yutish3/High-speed-LFR/README.md

# LFR - 2026
STM32 line follower robot on a custom 2-layer PCB. Black Pill (STM32F411) as a brain, TB6612FNG motor driver, 16-channel ARC16 line sensor, MPU6050 , and 3S LiPo through a 5V buck converter.



## VISION
I wanted to make a LFR that will be really good for competitions and i didt wanted it to fail mid run or during travel so i decided to make a pcb for it



Main goals:
- everything on a single PCB: power, motor driver, sensor connector, IMU
- run straight from a 3S LiPo with a power switch
- battery voltage monitoring so the robot knows when the pack is getting low (used 2 resistors for it connected to blackpill)
- status LEDs, a RESET button and a SAVE button for calibration
- test points for power pins

## what makes it special (main components)

&#9679; STM32F411CEU6 (Black Pill) :- main microcontroller, 100 MHz Cortex-M4 with hardware FPU

&#9679; TB6612FNG :- dual H-bridge motor driver for two N20 gear motors

&#9679; ARC16 :- 16-channel IR line sensor array on a single 8-pin header

&#9679; MPU6050 :- 6-axis IMU for gyro-assisted turning and stabilisation

&#9679; 3S LiPo + buck converter :- 11.1V battery, with the 5V rail for the sensor and the MCU

&#9679; N20 600 RPM motors :- small, light and fast for the size

## Images











## Bill of Materials

| Component | Purpose | Qty | Cost (INR) | Distributor |
| --- | --- | --- | --- | --- |
| N20 12V 600 RPM motor | main motor | 4 | ₹916 | Online |
| 11.1V 850mAh 30C 3S LiPo Battery Pack | Main power | 1 | ₹1,159 | Online |
| ARC16 Line Sensor | 16-channel IR line sensor array | 1 | ₹1,499 | Online |
| N20 Wheels | wheels | 1 | ₹349 | Online |
| N20 Caster Ball Wheel | Third support point | 1 | ₹39 | Online |
| Push Button 6x6x5 (pack of 10) | RESET and SAVE buttons | 1 | ₹19 | Online |
| 100 uF 35V cap | VSW bulk decoupling | 2 | ₹24 | Online |
| 220 uF 25V cap | +5V bulk decoupling | 4 | ₹28 | Online |
| XT60 Female to Nylon T-Connector | Battery plug adapter | 1 | ₹131 | Online |
| XT60PW Male Connector | Battery connector | 1 | ₹70 | Online |
| Rocker Switch | Main power switch | 1 | ₹12 | Online |
| Black Pill (STM32F411CEU6) | Main microcontroller | 1 | - | Bought offline |
| TB6612FNG Motor Driver | Dual motor driver | 1 | - | Bought offline |
| MPU6050 Module | 6-axis IMU | 1 | - | Bought offline |
| 5V Buck Converter Module | Battery to 5V (BUCK1) | 1 | - | Bought offline |
| Custom PCB | PCB | 1 | 1500 | whypcb |
