yutish3/High-speed-LFR/production/LFR_pcb_bom.csv

Designator | Footprint | Quantity | Value | LCSC Part #
+3V3 | TestPoint_THTPad_D2.0mm_Drill1.0mm | 1 | +3V3
+5V | TestPoint_THTPad_D2.0mm_Drill1.0mm | 1 | +5V
BLACK-PILL1 | BLACK PILL | 1 | ~
BUCK1 | Untitled_1 | 1 | ~
C1, C3 | CP_Radial_D6.3mm_P2.50mm | 2 | 100µF
C2, C4 | CP_Radial_D8.0mm_P3.50mm | 2 | 220µF
D1 | LED_D3.0mm | 1 | GREEN
D2 | LED_D3.0mm | 1 | RED
GND | TestPoint_THTPad_D2.0mm_Drill1.0mm | 1 | GND
J1 | AMASS_XT60PW-M_1x02_P7.20mm_Horizontal | 1 | Battery connector
J4 | SolderWire-0.25sqmm_1x02_P4.2mm_D0.65mm_OD1.7mm | 1 | LEFT MOTOR
J5 | SolderWire-0.25sqmm_1x02_P4.2mm_D0.65mm_OD1.7mm | 1 | RIGHT MOTOR
J7 | PinHeader_1x08_P2.54mm_Vertical | 1 | LFS-16A sensor
J9 | PinSocket_1x08_P2.54mm_Vertical | 1 | MPU6050
JW2 | SolderWire-0.5sqmm_1x02_P4.6mm_D0.9mm_OD2.1mm | 1 | SWITCH
R1, R2 | R_Axial_DIN0207_L6.3mm_D2.5mm_P10.16mm_Horizontal | 2 | 330Ω
R3, R6 | R_Axial_DIN0207_L6.3mm_D2.5mm_P10.16mm_Horizontal | 2 | 10k
R4 | R_Axial_DIN0207_L6.3mm_D2.5mm_P10.16mm_Horizontal | 1 | 15k
R5 | R_Axial_DIN0207_L6.3mm_D2.5mm_P10.16mm_Horizontal | 1 | 33k
RESET | SW_PUSH_6mm | 1 | RESET
SAVE | SW_PUSH_6mm | 1 | SAVE
U2 | TB6612FNG_Breakout_2x07_P2.54mm | 1 | TB6612FNG_Module
VSW | TestPoint_THTPad_D2.0mm_Drill1.0mm | 1 | VSW
