yutish3/High-speed-LFR/CAD file/3d print file.step

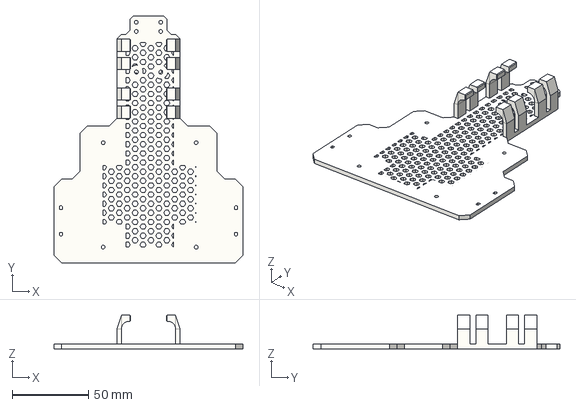
[picture p1: CAD file, 2026-11-07]
CAD file/3d print file.step
124.0 x 161.8 x 22.0 mm
