yutish3/High-speed-LFR/(list of files, cad)

Other CAD files:
CAD file/new LFR chassis.f3z
