yutish3/High-speed-LFR/lfr-main files/lfr.kicad_pcb

## KiCad design lfr-main files/lfr.kicad_pcb (2026-10-20)

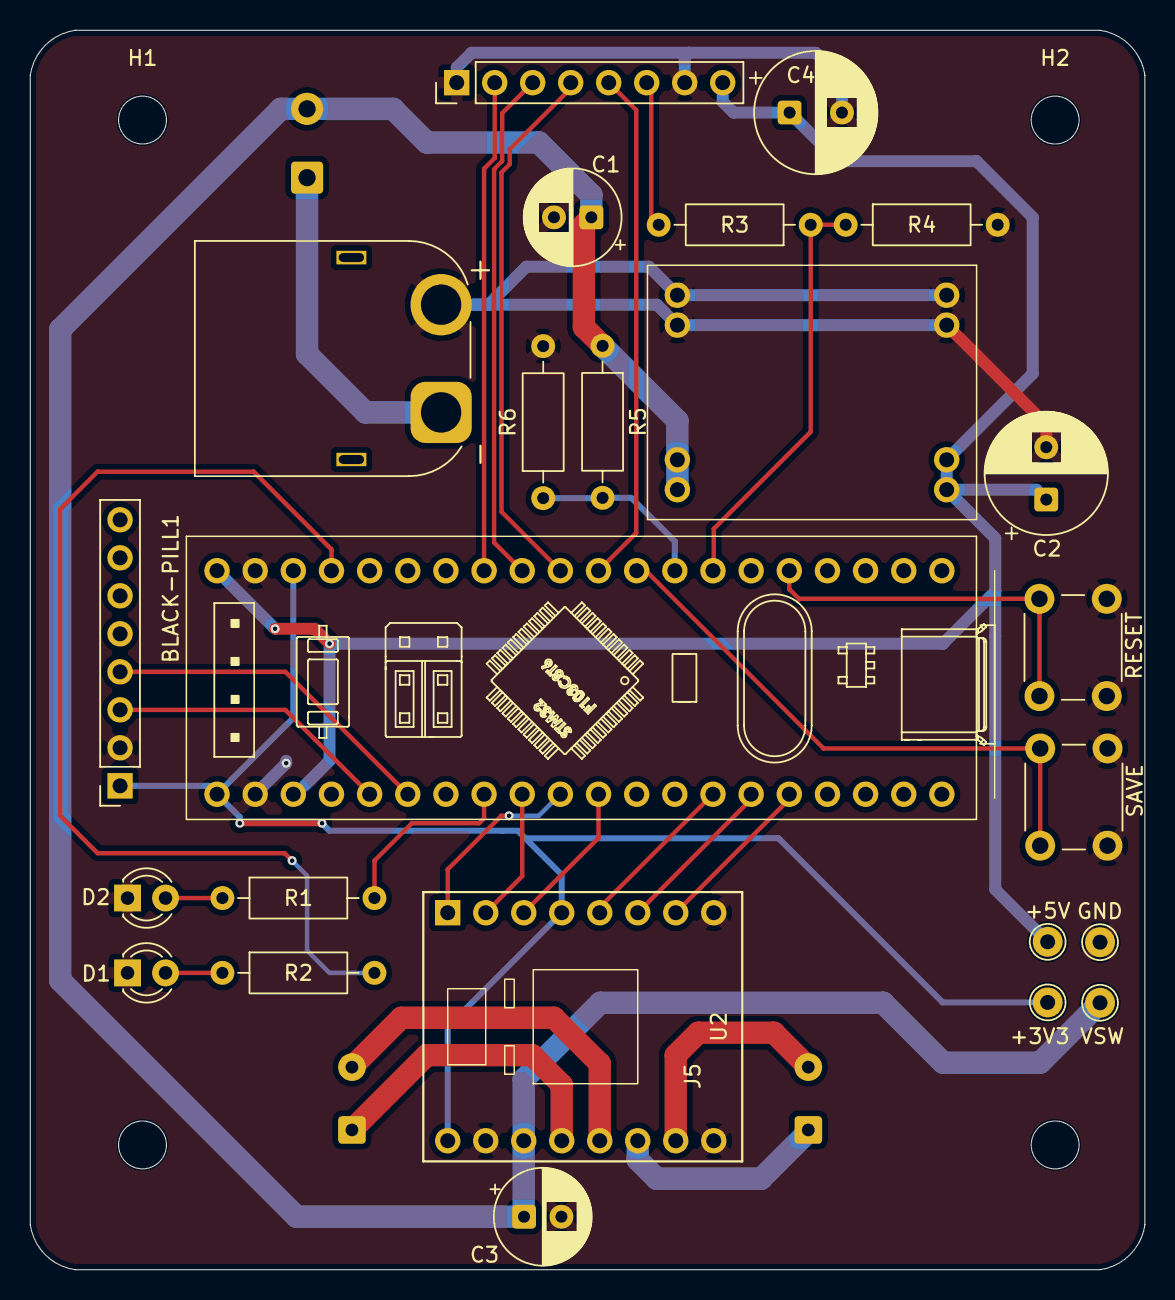
[picture p2: board lfr.kicad_pcb from above]

Board: 2 copper layers, 74.5 x 82.8 mm, 31 parts (0 on the bottom side), 30 nets.

Parts:
+3V3: +3V3; TestPoint_THTPad_D2.0mm_Drill1.0mm
+5V: +5V; TestPoint_THTPad_D2.0mm_Drill1.0mm
BLACK-PILL1: BLACK PILL
BUCK1: Untitled_1
C1, C3: 100µF; CP_Radial_D6.3mm_P2.50mm
C2, C4: 220µF; CP_Radial_D8.0mm_P3.50mm
D1: GREEN; LED_D3.0mm
D2: RED; LED_D3.0mm
GND: GND; TestPoint_THTPad_D2.0mm_Drill1.0mm
H1, H2, H3, H4: MountingHole; MountingHole_3.2mm_M3
J1: Battery connector; AMASS_XT60PW-M_1x02_P7.20mm_Horizontal
J4: LEFT MOTOR; SolderWire-0.25sqmm_1x02_P4.2mm_D0.65mm_OD1.7mm
J5: RIGHT MOTOR; SolderWire-0.25sqmm_1x02_P4.2mm_D0.65mm_OD1.7mm
J7: LFS-16A sensor; PinHeader_1x08_P2.54mm_Vertical
J9: MPU6050; PinSocket_1x08_P2.54mm_Vertical
Jw2: SWITCH; SolderWire-0.5sqmm_1x02_P4.6mm_D0.9mm_OD2.1mm
R1, R2: 330Ω; R_Axial_DIN0207_L6.3mm_D2.5mm_P10.16mm_Horizontal
R3: 10k; R_Axial_DIN0207_L6.3mm_D2.5mm_P10.16mm_Horizontal
R4: 15k; R_Axial_DIN0207_L6.3mm_D2.5mm_P10.16mm_Horizontal
R5: 33k; R_Axial_DIN0207_L6.3mm_D2.5mm_P10.16mm_Horizontal
R6: 10K; R_Axial_DIN0207_L6.3mm_D2.5mm_P10.16mm_Horizontal
RESET: RESET; SW_PUSH_6mm
SAVE: SAVE; SW_PUSH_6mm
U2: TB6612FNG_Module; TB6612FNG_Breakout_2x07_P2.54mm
VSW: VSW; TestPoint_THTPad_D2.0mm_Drill1.0mm

Connections:
+3V3: +3V3.1 (1_1), BLACK-PILL1.18 (3V3), BLACK-PILL1.21 (3V3), J9.1 (VCC), U2.4 (STBY), U2.9 (VCC)
+5V: +5V.1 (1_1), BLACK-PILL1.20 (5V), BLACK-PILL1.23 (5V), BUCK1.3 (OUT+), BUCK1.4 (OUT+), C2.1, C4.1, J7.8 (5V)
A1: BLACK-PILL1.7 (A1), R3.1, R4.1
A01: J4.1 (LM1), U2.12 (AO1)
A2: BLACK-PILL1.8 (A2), R5.2, R6.1
A02: J4.2 (LM2), U2.13 (AO2)
A3: BLACK-PILL1.9 (A3), SAVE.1
A4: BLACK-PILL1.10 (A4), J7.5 (S0)
A5: BLACK-PILL1.11 (A5), J7.4 (S1)
A6: BLACK-PILL1.12 (A6), J7.3 (S2)
A7: BLACK-PILL1.13 (A7), J7.2 (S3)
B1: BLACK-PILL1.36 (A8), U2.7 (PWMB)
B01: J5.1 (RM1), U2.14 (BO2)
B02: J5.2 (RM2), U2.15 (BO1)
B3: BLACK-PILL1.30 (B3), U2.1 (PWMA)
B6: BLACK-PILL1.25 (B8), J9.3 (SCL)
B7: BLACK-PILL1.26 (B7), J9.4 (SDA)
B10: BLACK-PILL1.17 (B10), R2.2
B12: BLACK-PILL1.31 (A15), U2.3 (AIN1)
B13: BLACK-PILL1.29 (B4), U2.2 (AIN2)
B14: BLACK-PILL1.34 (A10), U2.5 (BIN1)
B15: BLACK-PILL1.35 (A9), U2.6 (BIN2)
GND: BLACK-PILL1.19 (GND), BLACK-PILL1.22 (GND), BUCK1.1 (OUT-), BUCK1.2 (OUT-), BUCK1.5 (IN-), BUCK1.6 (IN-), C1.2, C2.2, C3.2, C4.2, D1.1 (K), D2.1 (K), GND.1 (1_1), J1.2 (-), J7.1 (E), J7.7 (GND), J9.2 (GND), R4.2, R6.2, RESET.2, SAVE.2, U2.8 (GND), U2.10 (GND), U2.16 (GND)
unnamed: BLACK-PILL1.28 (B5), R1.2
unnamed: D1.2 (A), R2.1
unnamed: D2.2 (A), R1.1
unnamed: J7.6 (SIG), R3.2
R: BLACK-PILL1.5 (R), RESET.1
VBAT: J1.1 (+), Jw2.1 (S1)
VSW: BUCK1.7 (IN+), BUCK1.8 (IN+), C1.1, C3.1, Jw2.2 (S2), R5.1, U2.11 (VM), VSW.1 (1_1)
